IprahimTurgut1/2627_ESE_PROJET_WALL-E/hardware/Projet Wall E/projet/projet.csv

Reference | Qty | Value | DNP | Exclude from BOM | Footprint | JLCPCB Part #
C201,C203,C208,C209,C210,C211,C212,C403 | 8 | 10u |  |  | Capacitor_SMD:C_0603_1608Metric | C19702
C202,C205,C307,C312,C313 | 5 | 1u |  |  | Capacitor_SMD:C_0402_1005Metric | C52923
C204,C402 | 2 | 2u2 |  |  | Capacitor_SMD:C_0402_1005Metric | C12530
C206,C305 | 2 | 4u7 |  |  | Capacitor_SMD:C_0603_1608Metric | C19666
C207 | 1 | 47n |  |  | Capacitor_SMD:C_0402_1005Metric | C307434
C301,C302,C303,C304,C308,C309,C501,C502,C504,C505,C507,C508 | 12 | 100n |  |  | Capacitor_SMD:C_0402_1005Metric | C1525
C306,C401 | 2 | 10n |  |  | Capacitor_SMD:C_0402_1005Metric | C15195
C310,C311 | 2 | 10p |  |  | Capacitor_SMD:C_0402_1005Metric | C1545
C404 | 1 | 470u/25V |  |  | Capacitor_SMD:CP_Elec_10x10.5 | C3829835
C503,C506,C509 | 3 | 10uF |  |  | Capacitor_SMD:C_0402_1005Metric | C15525
D201,D202,D301,D302 | 4 | LED |  |  | LED_SMD:LED_0603_1608Metric | C2286
F201 | 1 | Fuse |  |  | Fuse:Fuse_1206_3216Metric | C545216
J201 | 1 | USB_C_Receptacle_USB2.0_16P |  |  | Connector_USB:USB_C_Receptacle_HRO_TYPE-C-31-M-12 | C165948
J202 | 1 | Conn_01x02 |  |  | Connector_JST:JST_PH_S2B-PH-SM4-TB_1x02-1MP_P2.00mm_Horizontal | C295747
J301 | 1 | Conn_ST_STDC14 |  |  | Connector_PinHeader_1.27mm:PinHeader_2x07_P1.27mm_Vertical_SMD | C7465995
L201 | 1 | 1u |  |  | Inductor_SMD:L_Sunlord_SWPA4030S | C316359
Q201 | 1 | 2SK3019 |  |  | Package_TO_SOT_SMD:SOT-523 | C475595
Q202 | 1 | MMDT5401 |  |  | Package_TO_SOT_SMD:SOT-363_SC-70-6 | C968396
Q203 | 1 | DMP3099L |  |  | Package_TO_SOT_SMD:SOT-23 | C155244
R201,R204,R206,R207,R216,R217,R301 | 7 | 10k |  |  | Resistor_SMD:R_0402_1005Metric | C25744
R202,R203 | 2 | 5k1 |  |  | Resistor_SMD:R_0402_1005Metric | C25905
R205 | 1 | 100 |  |  | Resistor_SMD:R_0402_1005Metric | C25076
R208,R211 | 2 | 100k |  |  | Resistor_SMD:R_0402_1005Metric | C25741
R209 | 1 | 4k7 |  |  | Resistor_SMD:R_0402_1005Metric | C25900
R210,R212 | 2 | 1.5k |  |  | Resistor_SMD:R_0402_1005Metric | C25867
R213 | 1 | 470 |  |  | Resistor_SMD:R_0402_1005Metric | C25117
R214,R215 | 2 | 2k2 |  |  | Resistor_SMD:R_0402_1005Metric | C25879
R218 | 1 | 10m |  |  | Resistor_SMD:R_0805_2012Metric | C723359
R302,R303 | 2 | 1k |  |  | Resistor_SMD:R_0402_1005Metric | C11702
R401,R402 | 2 | 200m |  |  | Resistor_SMD:R_1206_3216Metric | C2840871
R403 | 1 | 10k |  |  | Resistor_SMD:R_0603_1608Metric | C25804
U201 | 1 | AP2112K-3.3 |  |  | Package_TO_SOT_SMD:SOT-23-5 | C51118
U202 | 1 | BQ27220YZFR |  |  | Package_BGA:Texas_DSBGA-9_1.62x1.58mm_Layout3x3_P0.5mm | C528617
U203 | 1 | USBLC6-2SC6 |  |  | Package_TO_SOT_SMD:SOT-23-6 | C7519
U204 | 1 | BQ25896RTW |  |  | Package_DFN_QFN:Texas_RTW_WQFN-24-1EP_4x4mm_P0.5mm_EP2.7x2.7mm_ThermalVias | C181475
U301 | 1 | STM32G431RBTx |  |  | Package_QFP:LQFP-64_10x10mm_P0.5mm | C431633
U401 | 1 | DRV8833PWP |  |  | Package_SO:HTSSOP-16-1EP_4.4x5mm_P0.65mm_EP3.4x5mm_Mask2.46x2.31mm_ThermalVias | C50506
U501 | 1 | SN74AHCT1G125DBVR |  |  | Package_TO_SOT_SMD:SOT-23-5 | C20617903
Y301 | 1 | 16MHz |  |  | Crystal:Crystal_SMD_EuroQuartz_MT-4Pin_3.2x2.5mm | C13738
