IprahimTurgut1/2627_ESE_PROJET_WALL-E/hardware/Projet Wall E/projet/projet.kicad_pcb

## KiCad design hardware/Projet Wall E/projet/projet.kicad_pcb (2026-10-18)

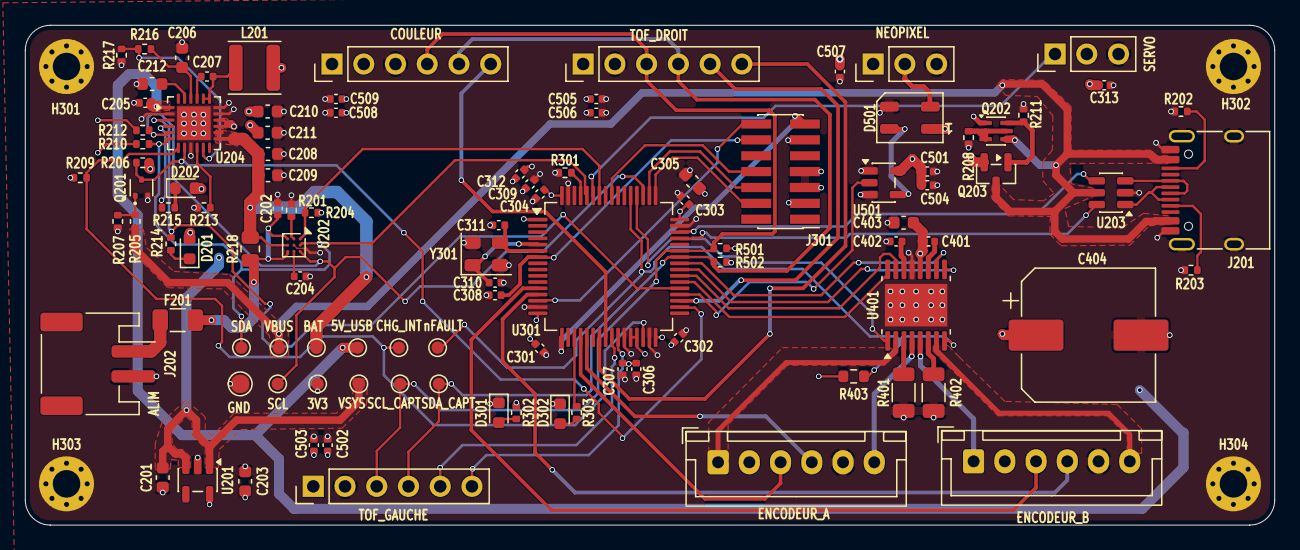
[picture p1: board projet.kicad_pcb from above]

Board: 4 copper layers, 100.0 x 40.0 mm, 108 parts (0 on the bottom side), 75 nets.

Parts:
3V3: +3.3V; TestPoint_Pad_D1.0mm
5V_USB: +5V_USB; TestPoint_Pad_D1.0mm
BAT: BAT; TestPoint_Pad_D1.0mm
C201, C203, C208, C209, C210, C211, C212, C403: 10u; C_0603_1608Metric
C202, C205, C307, C312, C313: 1u; C_0402_1005Metric
C204: 2u2; C_0402_1005Metric
C206, C305: 4u7; C_0603_1608Metric
C207: 47n; C_0402_1005Metric
C301, C302, C303, C304, C308, C309, C501, C504, C507: 100n; C_0402_1005Metric
C306, C401: 10n; C_0402_1005Metric
C310, C311: 10p; C_0402_1005Metric
C402: 2.2uF; C_0402_1005Metric
C404: 470u/25V; CP_Elec_10x10.5
C502, C505, C508: 100nF; C_0402_1005Metric
C503, C506, C509: 10uF; C_0402_1005Metric
CHG_INT: CHG_INT; TestPoint_Pad_D1.0mm
COULEUR: Conn_01x06; PinHeader_1x06_P2.54mm_Vertical
D201, D202: LED; LED_0603_1608Metric
D301: POWER; LED_0603_1608Metric
D302: STATUS; LED_0603_1608Metric
D501: WS2812B; LED_WS2812B-Mini_PLCC4_3.5x3.5mm
ENCODEUR_A: Conn_01x06; JST_XH_B6B-XH-A_1x06_P2.50mm_Vertical
ENCODEUR_B: Conn_01x06; JST_XH_B6B-XH-A_1x06_P2.50mm_Vertical
F201: Fuse; Fuse_1206_3216Metric
GND: GND; TestPoint_Pad_D1.5mm
H301, H302, H303, H304: MountingHole_Pad; MountingHole_2.2mm_M2_Pad_Via
J201: USB_C_Receptacle_USB2.0_16P; USB_C_Receptacle_HRO_TYPE-C-31-M-12
J202: Conn_01x02; JST_PH_S2B-PH-SM4-TB_1x02-1MP_P2.00mm_Horizontal
J301: Conn_ST_STDC14; PinHeader_2x07_P1.27mm_Vertical_SMD
L201: 1u; L_Sunlord_SWPA4030S
NEOPIXEL: Conn_01x03; PinHeader_1x03_P2.54mm_Vertical
Q201: 2SK3019; SOT-523
Q202: MMDT5401; SOT-363_SC-70-6
Q203: DMP3099L; SOT-23
R201, R204, R206, R207, R216, R217, R301: 10k; R_0402_1005Metric
R202, R203: 5k1; R_0402_1005Metric
R205: 100; R_0402_1005Metric
R208, R211: 100k; R_0402_1005Metric
R209: 4k7; R_0402_1005Metric
R210, R212: 1.5k; R_0402_1005Metric
R213: 470; R_0402_1005Metric
R214, R215: 2k2; R_0402_1005Metric
R218: 10m; R_0805_2012Metric
R302, R303: 1k; R_0402_1005Metric
R401, R402: 200m; R_1206_3216Metric
R403: 10k; R_0603_1608Metric
R501, R502: 4.7k; R_0402_1005Metric
SCL: SCL; TestPoint_Pad_D1.0mm
SCL_CAPT: SCL_CAPT; TestPoint_Pad_D1.0mm
SDA: SDA; TestPoint_Pad_D1.0mm
SDA_CAPT: SDA_CAPT; TestPoint_Pad_D1.0mm
SERVO: Conn_01x03; PinHeader_1x03_P2.54mm_Vertical
TOF_DROIT: Conn_01x06; PinHeader_1x06_P2.54mm_Vertical
TOF_GAUCHE: Conn_01x06; PinHeader_1x06_P2.54mm_Vertical
U201: AP2112K-3.3; SOT-23-5
U202: BQ27220YZFR; Texas_DSBGA-9_1.62x1.58mm_Layout3x3_P0.5mm
U203: USBLC6-2SC6; SOT-23-6
U204: BQ25896RTW; Texas_RTW_WQFN-24-1EP_4x4mm_P0.5mm_EP2.7x2.7mm_ThermalVias
U301: STM32G431RBTx; LQFP-64_10x10mm_P0.5mm
U401: DRV8833PWP; HTSSOP-16-1EP_4.4x5mm_P0.65mm_EP3.4x5mm_Mask2.46x2.31mm_The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
U501: SN74AHCT1G125DBVR; SOT-23-5
VBUS: VBUS; TestPoint_Pad_D1.0mm
VSYS: VSYS; TestPoint_Pad_D1.0mm
Y301: 16MHz; Crystal_SMD_EuroQuartz_MT-4Pin_3.2x2.5mm
nFAULT: MOT_nFAULT; TestPoint_Pad_D1.0mm

Connections:
+3.3V: 3V3.1 (1_1), C203.1, C301.1, C302.1, C303.1, C304.1, C305.1, C306.1, C307.1, C309.1, C312.1, C502.1, C503.1, C505.1, C506.1, C508.1, C509.1, COULEUR.1, ENCODEUR_A.2, ENCODEUR_B.2, J301.3 (VCC), R204.2, R209.1, R210.1, R212.1, R302.1, R403.2, R501.1, R502.1, TOF_DROIT.1, TOF_GAUCHE.1, U201.5 (VOUT), U301.1 (VBAT), U301.16 (VDD), U301.28 (VREF+), U301.29 (VDDA), U301.32 (VDD), U301.48 (VDD), U301.64 (VDD)
+5V_USB: 5V_USB.1 (1_1), C205.1, C313.1, C401.1, C403.1, C404.1, C501.1, C504.2, C507.1, D501.1 (VDD), NEOPIXEL.1, Q202.1 (E1), Q203.2 (S), SERVO.2, U204.1 (VBUS), U401.12 (VM), U501.5 (VCC)
/Alimentation/BAT: BAT.1 (1_1), C208.2, C209.2, R218.2, U202.C2 (SRN), U204.13 (BAT), U204.14 (BAT)
/Alimentation/CHG_INT: CHG_INT.1 (1_1), R209.2, U204.7 (INT), U301.30 (PB10)
/Alimentation/CHG_OTG: Q201.3 (D), R206.2, U204.8 (OTG), U301.34 (PB12)
/Alimentation/CHG_PG: R214.2, U204.3 (~PG), U301.37 (PB15)
/Alimentation/GAUGE_INT: R204.1, U202.A1 (GPOUT), U301.58 (PB5)
/Alimentation/PACKP: C202.1, F201.1, R218.1, U202.C1 (SRP), U202.C3 (BAT)
/Alimentation/SCL: R212.2, SCL.1 (1_1), U202.A3 (SCL), U204.5 (SCL), U301.51 (PA15)
/Alimentation/SDA: R210.2, SDA.1 (1_1), U202.A2 (SDA), U204.6 (SDA), U301.60 (PB7)
/Alimentation/USB_DM: U203.6 (I/O1), U301.45 (PA11)
/Alimentation/USB_DP: U203.4 (I/O2), U301.46 (PA12)
/Capteur/APDS_INT: COULEUR.6, U301.24 (PB0)
/Capteur/NEOPIXEL: U301.36 (PB14), U501.2
/Capteur/NP_5V: D501.4 (DIN), U501.4
/Capteur/SCL_CAPT: COULEUR.4, R501.2, SCL_CAPT.1 (1_1), TOF_DROIT.3, TOF_GAUCHE.3, U301.43 (PA9)
/Capteur/SDA_CAPT: COULEUR.5, R502.2, SDA_CAPT.1 (1_1), TOF_DROIT.4, TOF_GAUCHE.4, U301.42 (PA8)
/Capteur/TOF_L_GPIO1: TOF_GAUCHE.5, U301.25 (PB1)
/Capteur/TOF_L_XSHUT: TOF_GAUCHE.6, U301.26 (PB2)
/Capteur/TOF_R_GPIO1: TOF_DROIT.5, U301.35 (PB13)
/Capteur/TOF_R_XSHUT: TOF_DROIT.6, U301.23 (PC5)
/MCU/BOOT0: R301.2, U301.61 (PB8)
/MCU/ENCA_AOUT: ENCODEUR_A.3, U301.20 (PA6)
/MCU/ENCA_BOUT: ENCODEUR_B.3, U301.12 (PA0)
/MCU/ENCB_AOUT: ENCODEUR_A.4, U301.21 (PA7)
/MCU/ENCB_BOUT: ENCODEUR_B.4, U301.13 (PA1)
/MCU/LED_STATUS: R303.1, U301.19 (PA5)
/MCU/MOT_AIN1: U301.38 (PC6), U401.16 (AIN1)
/MCU/MOT_AIN2: U301.39 (PC7), U401.15 (AIN2)
/MCU/MOT_BIN1: U301.40 (PC8), U401.9 (BIN1)
/MCU/MOT_BIN2: U301.41 (PC9), U401.10 (BIN2)
/MCU/MOT_nFAULT: R403.1, U301.53 (PC11), U401.8 (~FAULT), nFAULT.1 (1_1)
/MCU/MOT_nSLEEP: U301.52 (PC10), U401.1 (~SLEEP)
/MCU/NRST: C308.1, J301.12 (~RST), U301.7 (PG10)
/MCU/SERVO_PWM: SERVO.1, U301.59 (PB6)
/MCU/SWCLK: J301.6 (JCLK/SWCLK), U301.50 (PA14)
/MCU/SWDIO: J301.4 (JTMS/SWDIO), U301.49 (PA13)
/MCU/SWO: J301.8 (JTDO/SWO), U301.56 (PB3)
/MCU/VCP_RX: J301.13 (VCP_RX), U301.17 (PA3)
/MCU/VCP_TX: J301.14 (VCP_TX), U301.14 (PA2)
/Moteur/AOUT1: ENCODEUR_A.1, U401.2 (AOUT1)
/Moteur/AOUT2: ENCODEUR_A.6, U401.4 (AOUT2)
/Moteur/BOUT1: ENCODEUR_B.6, U401.7 (BOUT1)
/Moteur/BOUT2: ENCODEUR_B.1, U401.5 (BOUT2)
GND: C201.2, C202.2, C203.2, C204.2, C205.2, C206.1, C208.1, C209.1, C210.1, C211.1, C212.1, C301.2, C302.2, C303.2, C304.2, C305.2, C306.2, C307.2, C308.2, C309.2, C310.1, C311.1, C312.2, C313.2, C402.1, C403.2, C404.2, C501.2, C502.2, C503.2, C504.1, C505.2, C506.2, C507.2, C508.2, C509.2, COULEUR.3, D301.1 (K), D302.1 (K), D501.3 (VSS), ENCODEUR_A.5, ENCODEUR_B.5, GND.1 (1_1), H301.1 (1_1), H302.1 (1_1), H303.1 (1_1), H304.1 (1_1), J201.A1 (GND), J201.A12 (GND), J201.B1 (GND), J201.B12 (GND), J201.SH (SHIELD), J202.2, J301.5 (GND), J301.7 (GND), J301.11 (GNDDetect), NEOPIXEL.3, Q201.2 (S), R201.2, R202.2, R203.2, R207.2, R208.2, R211.2, R213.2, R217.2, R301.1, R401.1, R402.1, SERVO.3, TOF_DROIT.2, TOF_GAUCHE.2, U201.2 (GND), U202.B2 (V_{SS}), U203.2 (GND), U204.2 (PSEL), U204.9 (~CE), U204.17 (PGND), U204.18 (PGND), U204.25 (PGND), U301.15 (VSS), U301.27 (VSSA), U301.31 (VSS), U301.47 (VSS), U301.63 (VSS), U401.13 (GND), U401.17 (GND), U501.1, U501.3 (GND), Y301.2 (G), Y301.4 (G)
unnamed: C207.2, L201.1, U204.19 (SW), U204.20 (SW)
unnamed: D201.1 (K), R214.1
unnamed: D202.1 (K), R215.1
unnamed: D301.2 (A), R302.2
unnamed: D302.2 (A), R303.2
unnamed: D501.2 (DOUT), NEOPIXEL.2
unnamed: J201.A5 (CC1), R203.1
unnamed: J201.B5 (CC2), R202.1
unnamed: J201.A6 (D+), J201.B6 (D+), U203.3 (I/O2)
unnamed: J201.A7 (D-), J201.B7 (D-), U203.1 (I/O1)
unnamed: F201.2, J202.1
unnamed: Q201.1 (G), R205.2, R207.1
unnamed: Q202.2 (B1), Q202.3 (C2), Q202.5 (B2), R208.1
unnamed: Q202.6 (C1), Q203.1 (G), R211.1
unnamed: R201.1, U202.B1 (BIN)
unnamed: C204.1, U202.B3 (V_{DD})
unnamed: C207.1, U204.21 (BTST)
unnamed: R213.1, U204.10 (ILIM)
unnamed: C212.2, U204.23 (PMID)
unnamed: C206.2, R216.2, U204.22 (REGN)
unnamed: R215.2, U204.4 (STAT)
unnamed: R216.1, R217.1, U204.11 (TS)
unnamed: C310.2, U301.5 (PF0), Y301.1
unnamed: C311.2, U301.6 (PF1), Y301.3
unnamed: R401.2, U401.3 (AISEN)
unnamed: R402.2, U401.6 (BISEN)
unnamed: C401.2, U401.11 (VCP)
unnamed: C402.2, U401.14 (VINT)
VBUS: J201.A4 (VBUS), J201.A9 (VBUS), J201.B4 (VBUS), J201.B9 (VBUS), Q202.4 (E2), Q203.3 (D), R205.1, U203.5 (VBUS), VBUS.1 (1_1)
VSYS: C201.1, C210.2, C211.2, D201.2 (A), D202.2 (A), L201.2, R206.1, U201.1 (VIN), U201.3 (EN), U204.15 (SYS), U204.16 (SYS), VSYS.1 (1_1)
