IprahimTurgut1/2627_ESE_PROJET_WALL-E/software/Capteur ADA3595/IOC.ioc

Mcu.UserName=STM32G431RBTx
PA0.GPIO_Label=ENCA_BOUT
PA0.Signal=S_TIM2_CH1
PA1.GPIO_Label=ENCB_BOUT
PA1.Signal=S_TIM2_CH2
PA11.Signal=USB_DM
PA12.Signal=USB_DP
PA13.GPIO_Label=T_SWDIO
PA13.Signal=SYS_JTMS-SWDIO
PA14.GPIO_Label=T_SWCLK
PA14.Signal=SYS_JTCK-SWCLK
PA15.Signal=I2C1_SCL
PA2.GPIO_Label=VCP_TX
PA2.Signal=USART2_TX
PA3.GPIO_Label=VCP_RX
PA3.Signal=USART2_RX
PA5.GPIO_Label=LED_STATUS
PA5.Signal=GPIO_Output
PA6.GPIO_Label=ENCA_AOUT
PA6.Signal=S_TIM3_CH1
PA7.GPIO_Label=ENCB_AOUT
PA7.Signal=S_TIM3_CH2
PA8.Signal=I2C2_SDA
PA9.Signal=I2C2_SCL
PB0.GPIO_Label=APDS_INT
PB0.Signal=GPXTI0
PB1.GPIO_Label=TOF_L_GPIO1
PB1.Signal=GPIO_Input
PB10.GPIO_Label=CHG_INT
PB10.Signal=GPXTI10
PB12.GPIO_Label=CHG_PG
PB12.Signal=GPIO_Input
PB13.GPIO_Label=TOF_R_GPIO1
PB13.Signal=GPIO_Input
PB14.GPIO_Label=NEOPIXEL
PB14.Signal=S_TIM15_CH1
PB15.GPIO_Label=CHG_PG
PB15.Signal=GPIO_Input
PB2.GPIO_Label=TOF_L_XSHUT
PB2.Signal=GPIO_Output
PB3.GPIO_Label=T_SWO
PB3.Signal=SYS_JTDO-SWO
PB5.GPIO_Label=GAUGE_INT
PB5.Signal=GPXTI5
PB6.GPIO_Label=SERVO_PWM
PB6.Signal=S_TIM4_CH1
PB7.Signal=I2C1_SDA
PC10.GPIO_Label=MOT_nSLEEP
PC10.Signal=GPIO_Output
PC11.GPIO_Label=MOT_nFAULT
PC11.Signal=GPIO_Input
PC5.GPIO_Label=TOF_R_XSHUT
PC5.Signal=GPIO_Output
PC6.GPIO_Label=MOT_AIN1
PC6.Signal=S_TIM8_CH1
PC7.GPIO_Label=MOT_AIN2
PC7.Signal=S_TIM8_CH2
PC8.GPIO_Label=MOT_BIN1
PC8.Signal=S_TIM8_CH3
PC9.GPIO_Label=MOT_BIN2
PC9.Signal=S_TIM8_CH4
PF0-OSC_IN.GPIO_Label=RCC_OSC_IN
PF0-OSC_IN.Signal=RCC_OSC_IN
PF1-OSC_OUT.GPIO_Label=RCC_OSC_OUT
PF1-OSC_OUT.Signal=RCC_OSC_OUT
