IprahimTurgut1/2627_ESE_PROJET_WALL-E/(commit log)

2026-09-24 Ajout projet KiCad Wall-E + lib symboles wall_e
    [alim.kicad_sch, capteur.kicad_sch, mcu.kicad_sch, projet.kicad_pcb, projet.kicad_sch, puissance.kicad_sch]
2026-09-24 Alim : BQ25896 + BQ27220, symboles perso wall_e, USB vers MCU
    [alim.kicad_sch, mcu.kicad_sch]
2026-09-24 feat(puissance): integration du schema de puissance termine
    [puissance.kicad_sch]
2026-09-24 Alim : BQ25896 + BQ27220, diode idéale, USB vers MCU
    [alim.kicad_sch]
2026-09-24 feat(puissance): schema de puissance
    [puissance.kicad_sch]
2026-09-24 feat(moteur): renommage puissance en moteur et modif schéma
    [moteur.kicad_sch, projet.kicad_sch]
2026-09-30 Schéma alim : TVS D4, diode idéale +5V_USB, PWR_FLAG
    [alim.kicad_sch]
2026-09-30 Mise à jour alim, moteur et schéma principal
    [alim.kicad_sch, moteur.kicad_sch, projet.kicad_sch]
2026-09-30 Intégration du schéma moteur de feature-puissance
    [moteur.kicad_sch]
2026-09-30 Intégration du schéma capteurs de feature-capteurs
    [capteur.kicad_sch]
2026-09-30 Mise à jour MCU + ajout du fichier .ioc
    [capteur.kicad_sch, mcu.kicad_sch, moteur.kicad_sch]
2026-10-05 feat: mise a jour capteur et projet: empreintes
    [capteur.kicad_sch, mcu.kicad_sch, moteur.kicad_sch, projet.kicad_sch]
2026-10-05 feat(moteur) : ajustement finaux Lamyae
    [moteur.kicad_sch]
2026-10-05 refactor: conservation seulement du fichier moteur
    [alim.kicad_sch, capteur.kicad_sch, mcu.kicad_sch, projet.kicad_sch]
2026-10-05 Alim : refs JLCPCB, correction empreintes, renommage R30-R32
    [alim.kicad_sch]
2026-10-05 feat: mise a jour alim reference jlcpcb
    [alim.kicad_sch, capteur.kicad_sch, mcu.kicad_sch, moteur.kicad_sch, projet.csv]
2026-10-05 Corrections alim
    [alim.kicad_sch]
2026-10-05 Réparation fichiers alim et moteur
    [alim.kicad_sch, moteur.kicad_sch]
2026-10-05 Modifs capteur, mcu et moteur
    [capteur.kicad_sch, mcu.kicad_sch, moteur.kicad_sch]
2026-10-05 Petite modif MCU
    [mcu.kicad_sch]
2026-10-05 Intégration feuille capteurs depuis feature-capteurs
    [capteur.kicad_sch]
2026-10-05 Annotation par feuille + références JLCPCB Part #
    [alim.kicad_sch, capteur.kicad_sch, mcu.kicad_sch, moteur.kicad_sch]
2026-10-05 Feuille racine : liaisons hiérarchiques + corrections ERC
    [mcu.kicad_sch, moteur.kicad_sch, projet.kicad_sch]
2026-10-05 Modifs schématique
    [alim.kicad_sch, mcu.kicad_sch, moteur.kicad_sch]
2026-10-06 WIP : MCU et config software (en cours)
    [mcu.kicad_sch]
2026-10-06 Intégration feuille capteurs + MCU/software en cours
    [capteur.kicad_sch]
2026-10-06 Schéma : 0 erreur ERC, pinout MCU finalisé + config .ioc
    [alim.kicad_sch, capteur.kicad_sch, mcu.kicad_sch, projet.kicad_sch]
2026-10-06 Correction empreintes et références JLCPCB
    [alim.kicad_sch, capteur.kicad_sch, mcu.kicad_sch, moteur.kicad_sch]
2026-10-07 verification finale effectue
    [alim.kicad_sch, capteur.kicad_sch, mcu.kicad_sch, projet.kicad_pcb, projet.kicad_sch]
2026-10-07 PCB : contour 80x40, trous de fixation M2.5, sérigraphie
    [mcu.kicad_sch, projet.kicad_pcb]
2026-10-08 Ajout points de test + plans de masse PCB
    [alim.kicad_sch, capteur.kicad_sch, moteur.kicad_sch, projet.kicad_pcb]
2026-10-08 PCB : placement composants et points de test
    [alim.kicad_sch, capteur.kicad_sch, projet.kicad_pcb]
2026-10-08 correction erreur drc
    [alim.kicad_sch, capteur.kicad_sch, projet.kicad_pcb]
2026-10-09 (feat : Placement PCB 10*6cm et mise à jour TestPoint)
    [alim.kicad_sch, capteur.kicad_sch, mcu.kicad_sch, moteur.kicad_sch, projet.kicad_pcb]
2026-10-12 PCB : placement final avant routage
2026-10-12 PCB : routage GND et alimentations
2026-10-16 PCB : routage et contraintes DRC mises à jour
2026-10-16 feat(software): ajout du code STM32 pour le capteur de couleur APDS9960
2026-10-16 PCB : zones GND, suppression des îlots, DRC propre
2026-10-18 PCB : modif serigraphie
2026-10-18 Fichiers de fabrication : Gerbers, perçage, CPL et BOM
2026-10-18 Fabrication : BOM mise à jour, CPL corrigé (rotations JLCPCB), nouvelles références Q201/Q202/R218
